LuCy4n3/ESCboard/v2/ESC_HF/componente/ouroboros/Ouroboros_transparent.png

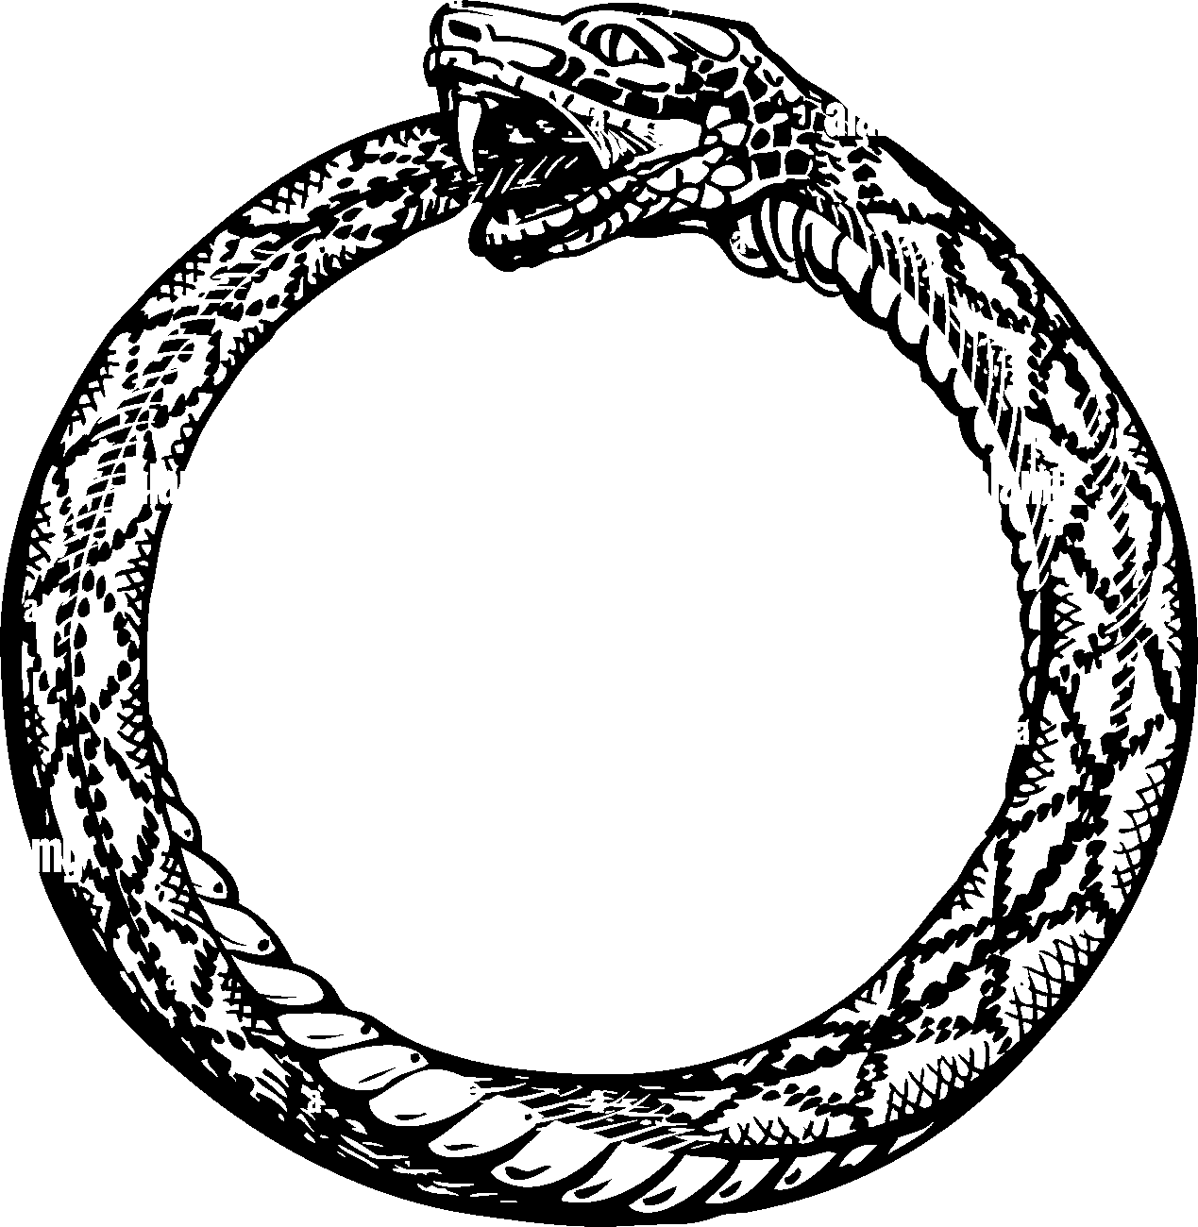
v2/ESC_HF/componente/ouroboros/Ouroboros_transparent.png
