LuCy4n3/ESCboard/v2/ESC_HF/componente/ouroboros/Simbol_KiCad_alb.png

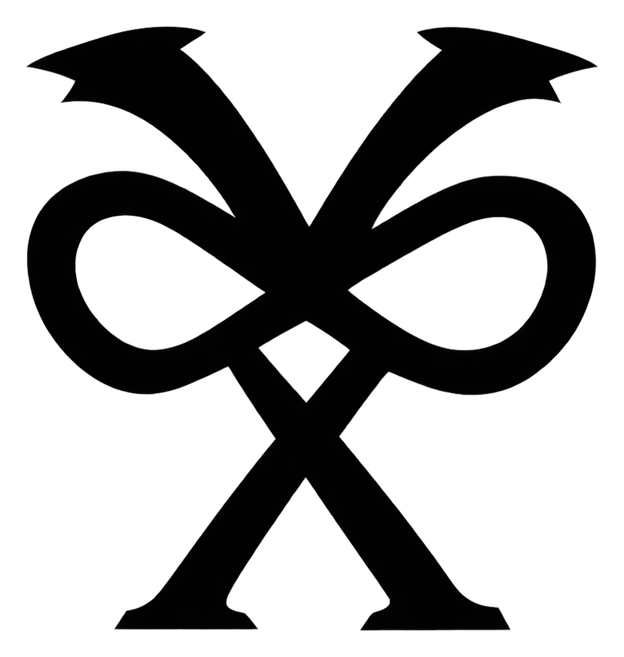
v2/ESC_HF/componente/ouroboros/Simbol_KiCad_alb.png
