LuCy4n3/ESCboard/v2/ESC_HF/componente/74437346220(inductor)/WE-LHMI_7030.step

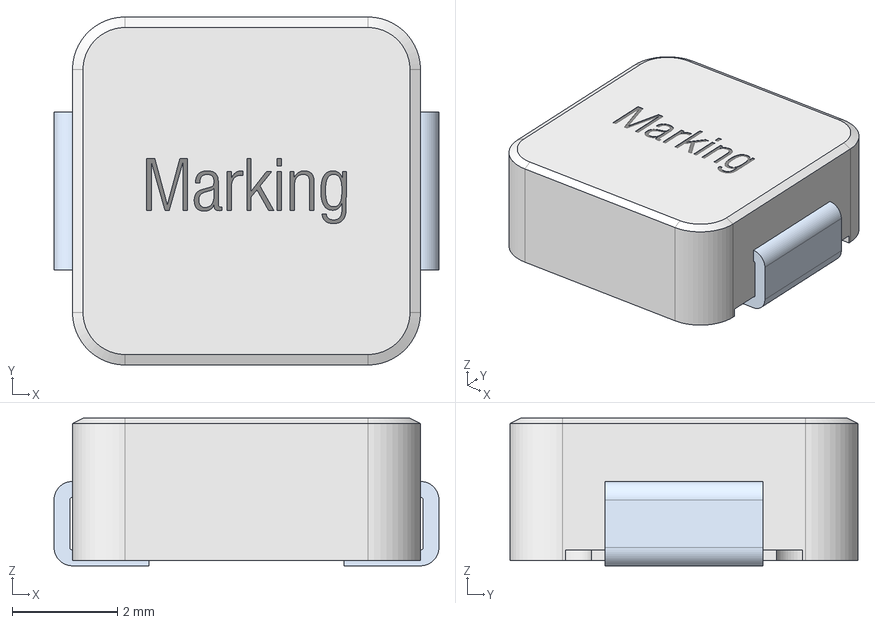
[picture p3: CAD file, 2026-11-10]
v2/ESC_HF/componente/74437346220(inductor)/WE-LHMI_7030.step
7.30 x 6.60 x 2.80 mm
