LuCy4n3/ESCboard/v2/ESC_HF/componente/CST272FK-13-R001AA/CST272FK-13-R001AA.step

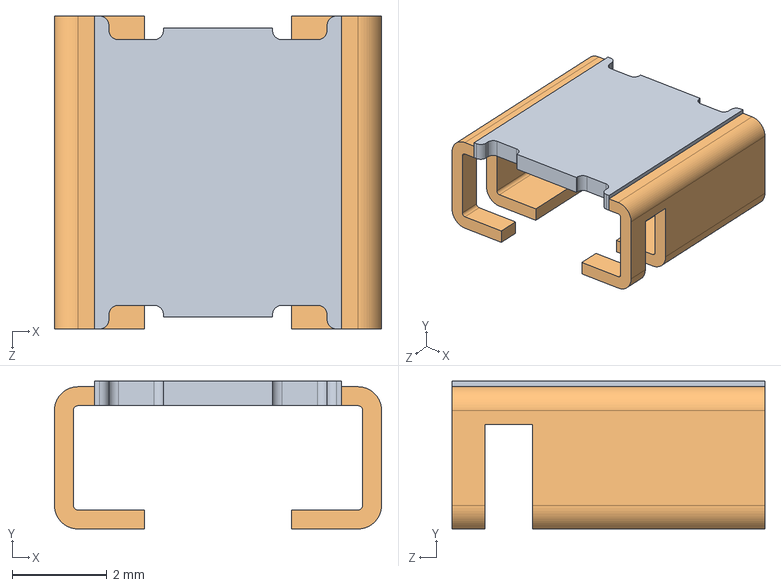
[picture p4: CAD file, 2026-11-10]
v2/ESC_HF/componente/CST272FK-13-R001AA/CST272FK-13-R001AA.step
6.90 x 3.12 x 6.60 mm
