LuCy4n3/ESCboard/v2/ESC_HF/componente/DRV8323RHRGZR/DRV8323RHRGZR.step

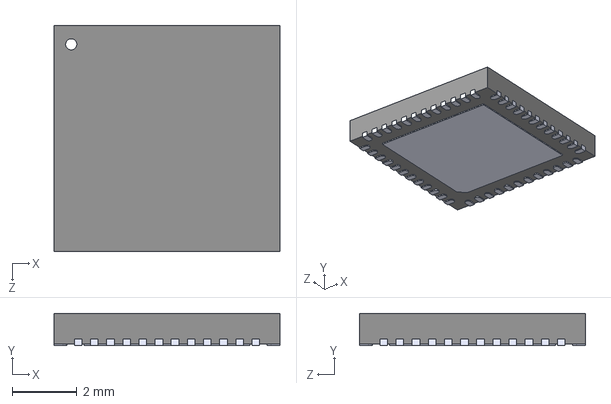
[picture p5: CAD file, 2026-11-10]
v2/ESC_HF/componente/DRV8323RHRGZR/DRV8323RHRGZR.step
7.00 x 1.00 x 7.00 mm
