LuCy4n3/ESCboard/v2/ESC_HF/componente/STM32H750VBT6/STM32H750VBT6TR.step

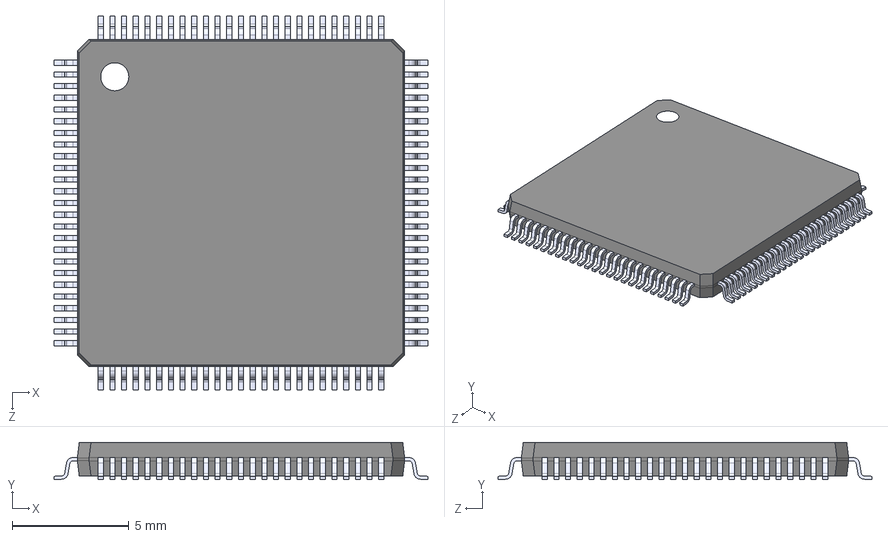
[picture p6: CAD file, 2026-11-10]
v2/ESC_HF/componente/STM32H750VBT6/STM32H750VBT6TR.step
16.0 x 1.60 x 16.0 mm
