LuCy4n3/ESCboard/v1/ESC_HS/esc_design/esc_design.kicad_pcb

## KiCad design v1/ESC_HS/esc_design/esc_design.kicad_pcb (2026-11-10, an earlier design)

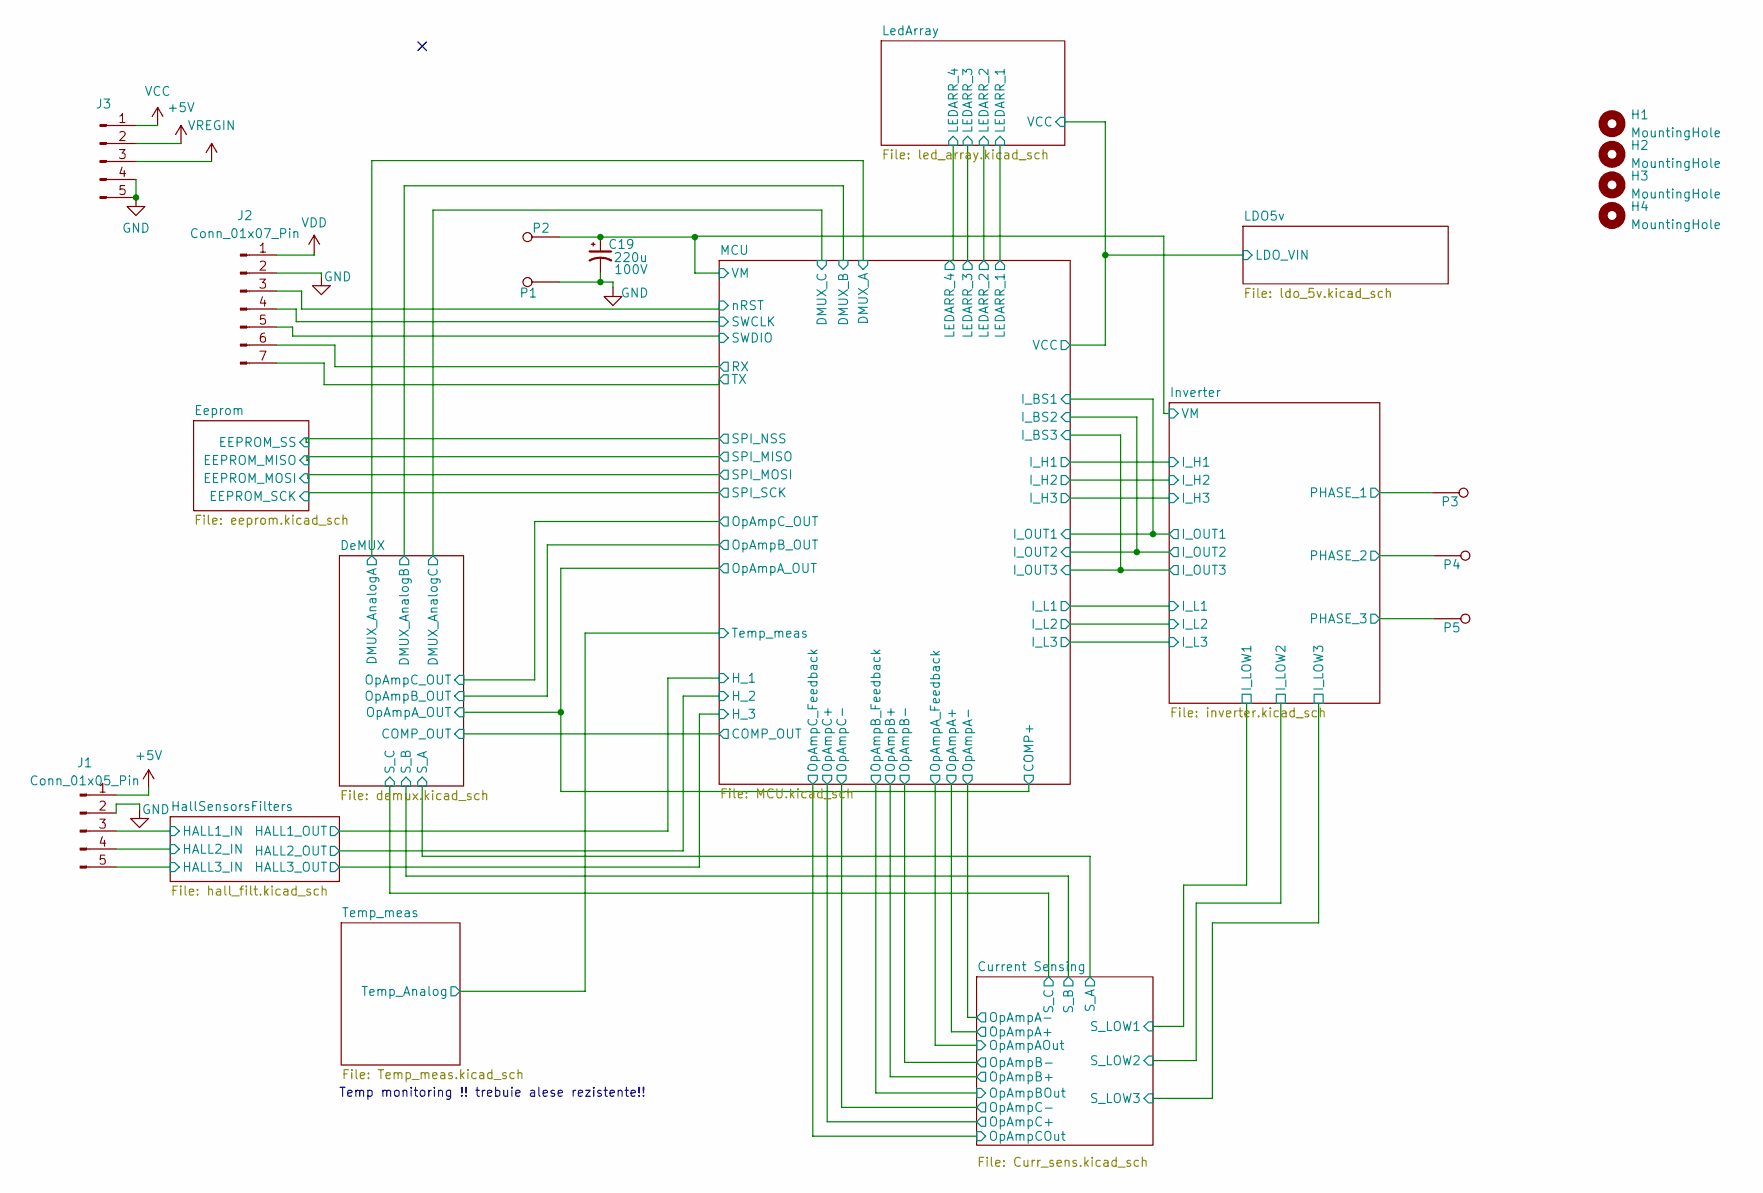
[picture p7: schematic esc_design.kicad_sch]

Parts:
C19: 220u; CP_Radial_D12.5mm_P5.00mm
H1, H2, H3, H4: MountingHole; MountingHole_3.2mm_M3
J1, J3: Conn_01x05_Pin; PinSocket_1x05_P2.54mm_Vertical
J2: Conn_01x07_Pin; PinSocket_1x07_P2.54mm_Vertical
P1, P2, P3, P4, P5: Conn_Power

Connections:
+5V: J1.1, J3.2; also elsewhere on the board
/HallSensorsFilters/HALL1_IN: J1.3; also elsewhere on the board
/HallSensorsFilters/HALL2_IN: J1.4; also elsewhere on the board
/HallSensorsFilters/HALL3_IN: J1.5; also elsewhere on the board
/Inverter/I_OUT1: P3.1; also elsewhere on the board
/Inverter/I_OUT2: P4.1; also elsewhere on the board
/Inverter/I_OUT3: P5.1; also elsewhere on the board
/Inverter/VM: C19.1, P2.1; also elsewhere on the board
/MCU/SWCLK: J2.4; also elsewhere on the board
/MCU/SWDIO: J2.5; also elsewhere on the board
/MCU/USART1_RX: J2.6; also elsewhere on the board
/MCU/USART1_TX: J2.7; also elsewhere on the board
/MCU/nRST: J2.3; also elsewhere on the board
VCC: J3.1; also elsewhere on the board
VDD: J2.1; also elsewhere on the board
VREGIN: J3.3; also elsewhere on the board

Notes on the sheet:
Temp monitoring !! trebuie alese rezistente!!

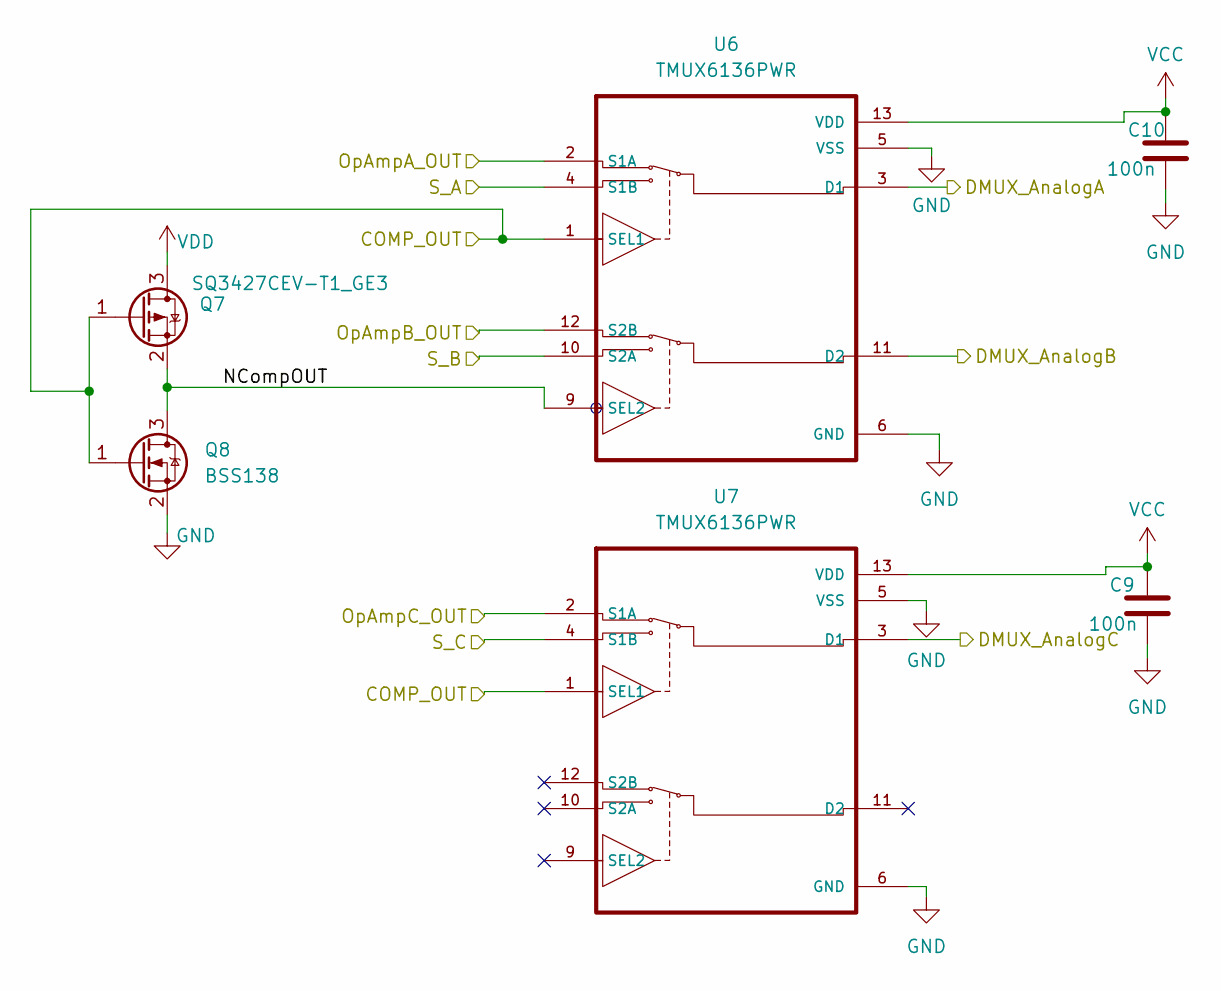
[picture p8: schematic demux.kicad_sch]

Parts:
C9, C10: 100n; C_0603_1608Metric_Pad1.08x0.95mm_HandSolder
Q7: SQ3427CEV-T1_GE3; SOT-23
Q8: BSS138; SOT-23
U6, U7: TMUX6136PWR; SOP65P640X120-16N

Connections:
/Current Sensing/S_A: U6.4 (S1B); also elsewhere on the board
/Current Sensing/S_B: U6.10 (S2A); also elsewhere on the board
/Current Sensing/S_C: U7.4 (S1B); also elsewhere on the board
/DeMUX/DMUX_AnalogA: U6.3 (D1); also elsewhere on the board
/DeMUX/DMUX_AnalogB: U6.11 (D2); also elsewhere on the board
/DeMUX/DMUX_AnalogC: U7.3 (D1); also elsewhere on the board
/DeMUX/NCompOUT: Q7.2 (S), Q8.3 (D), U6.9 (SEL2)
/MCU/COMP3+: U6.2 (S1A); also elsewhere on the board
/MCU/COMP3_OUT: Q7.1 (G), Q8.1 (G), U6.1 (SEL1), U7.1 (SEL1); also elsewhere on the board
/MCU/OpAmp2_OUT: U6.12 (S2B); also elsewhere on the board
/MCU/OpAmp3_OUT: U7.2 (S1A); also elsewhere on the board
VCC: C9.1, C10.1, U6.13 (VDD), U7.13 (VDD); also elsewhere on the board
VDD: Q7.3 (D); also elsewhere on the board

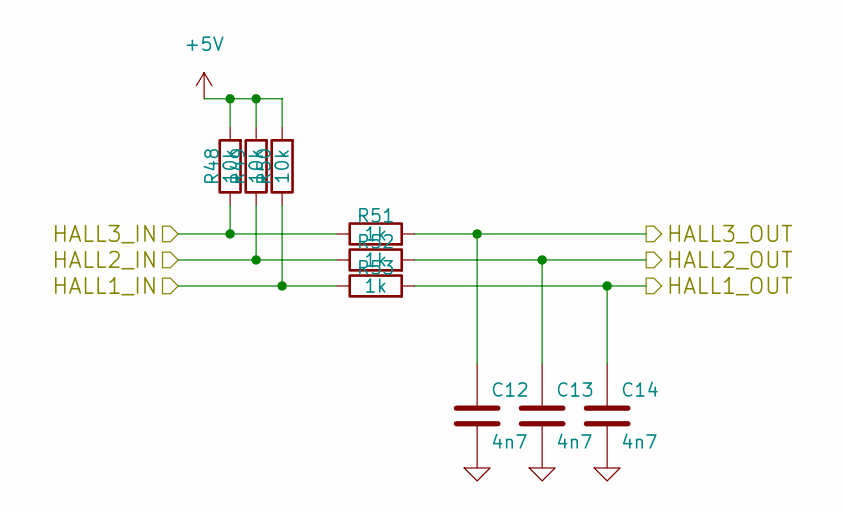
[picture p9: schematic hall_filt.kicad_sch]

Parts:
C12, C13, C14: 4n7; C_0603_1608Metric_Pad1.08x0.95mm_HandSolder
R48, R49, R50: 10k; R_0603_1608Metric_Pad0.98x0.95mm_HandSolder
R51, R52, R53: 1k; R_0603_1608Metric_Pad0.98x0.95mm_HandSolder

Connections:
+5V: R48.2, R49.2, R50.2; also elsewhere on the board
/HallSensorsFilters/HALL1_IN: R50.1, R53.1; also elsewhere on the board
/HallSensorsFilters/HALL1_OUT: C14.1, R53.2; also elsewhere on the board
/HallSensorsFilters/HALL2_IN: R49.1, R52.1; also elsewhere on the board
/HallSensorsFilters/HALL2_OUT: C13.1, R52.2; also elsewhere on the board
/HallSensorsFilters/HALL3_IN: R48.1, R51.1; also elsewhere on the board
/HallSensorsFilters/HALL3_OUT: C12.1, R51.2; also elsewhere on the board

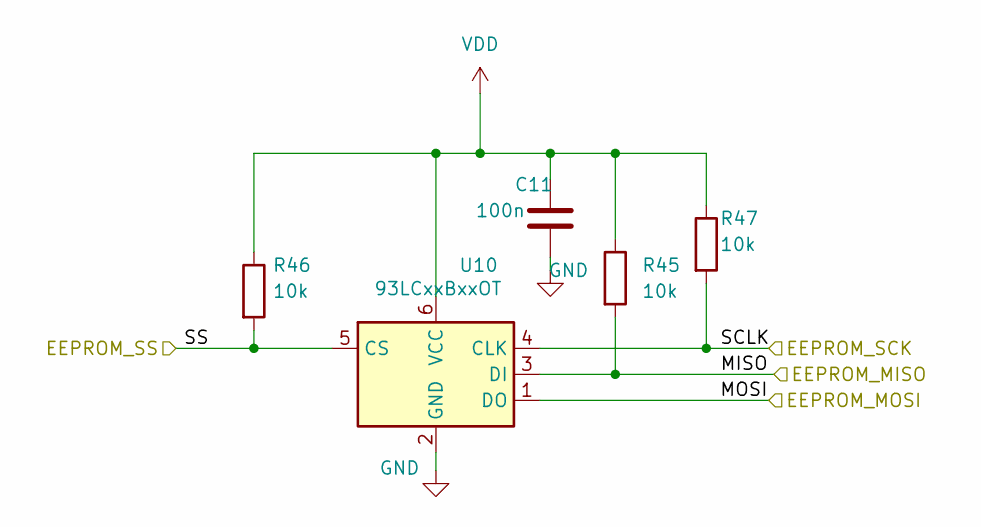
[picture p10: schematic eeprom.kicad_sch]

Parts:
C11: 100n; C_0603_1608Metric_Pad1.08x0.95mm_HandSolder
R45, R46, R47: 10k; R_0603_1608Metric_Pad0.98x0.95mm_HandSolder
U10: 93LCxxBxxOT; SOT-23-6

Connections:
/Eeprom/MISO: R45.2, U10.3 (DI); also elsewhere on the board
/Eeprom/MOSI: U10.1 (DO); also elsewhere on the board
/Eeprom/SCLK: R47.2, U10.4 (CLK); also elsewhere on the board
/Eeprom/SS: R46.2, U10.5 (CS); also elsewhere on the board
VDD: C11.1, R45.1, R46.1, R47.1, U10.6 (VCC); also elsewhere on the board

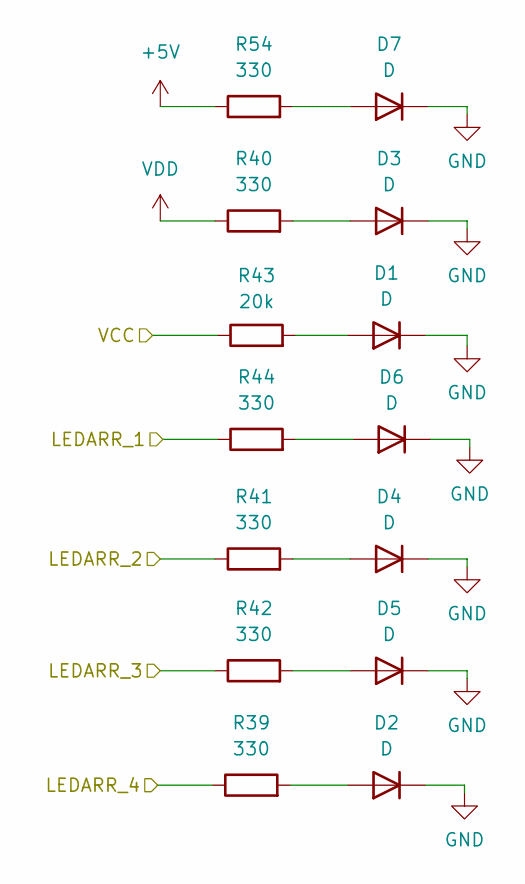
[picture p11: schematic led_array.kicad_sch]

Parts:
D1, D2, D3, D4, D5, D6, D7: D; D_1206_3216Metric_Pad1.42x1.75mm_HandSolder
R39, R40, R41, R42, R44, R54: 330; R_0603_1608Metric_Pad0.98x0.95mm_HandSolder
R43: 20k; R_0603_1608Metric_Pad0.98x0.95mm_HandSolder

Connections:
+5V: R54.1; also elsewhere on the board
/LedArray/LEDARR_1: R44.1; also elsewhere on the board
/LedArray/LEDARR_2: R41.1; also elsewhere on the board
/LedArray/LEDARR_3: R42.1; also elsewhere on the board
/LedArray/LEDARR_4: R39.1; also elsewhere on the board
unnamed: D1.2 (A), R43.2
unnamed: D2.2 (A), R39.2
unnamed: D3.2 (A), R40.2
unnamed: D4.2 (A), R41.2
unnamed: D5.2 (A), R42.2
unnamed: D6.2 (A), R44.2
unnamed: D7.2 (A), R54.2
VCC: R43.1; also elsewhere on the board
VDD: R40.1; also elsewhere on the board

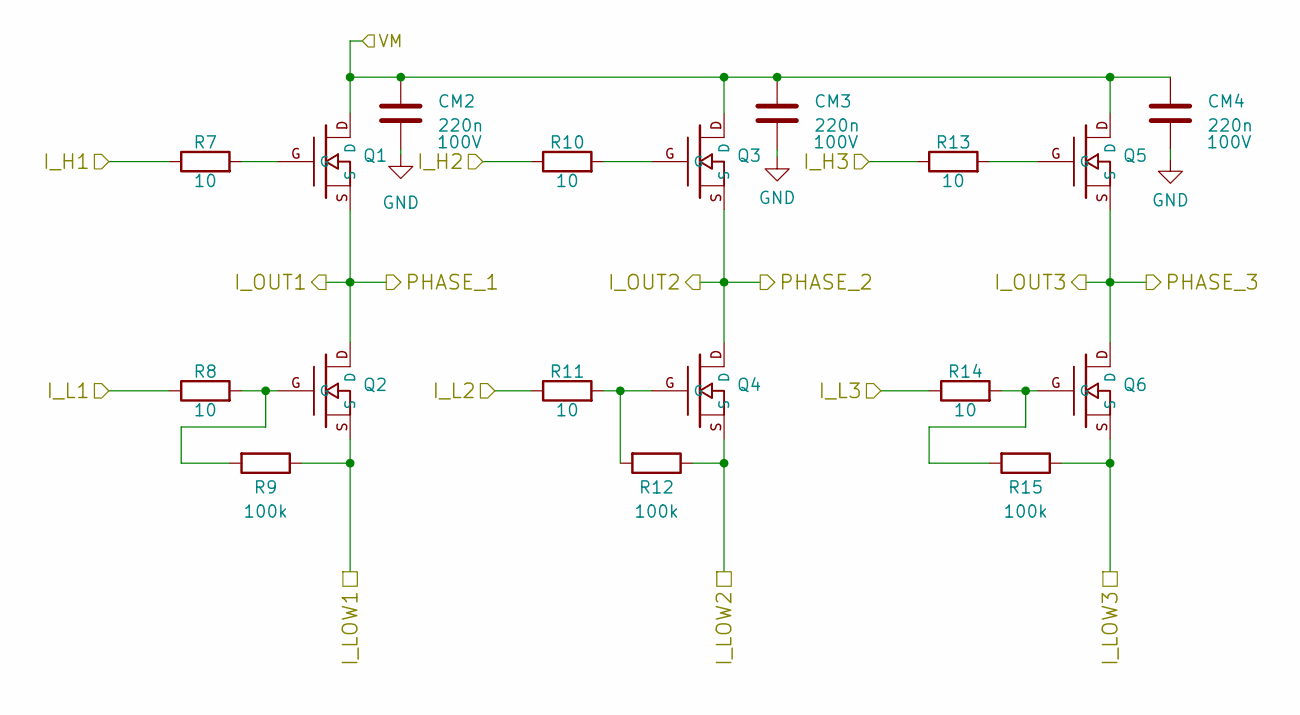
[picture p12: schematic inverter.kicad_sch]

Parts:
CM2, CM3, CM4: 220n; C_0603_1608Metric_Pad1.08x0.95mm_HandSolder
Q1, Q2, Q3, Q4, Q5, Q6: IRFS7530PBF
R7, R8, R10, R11, R13, R14: 10; R_0603_1608Metric_Pad0.98x0.95mm_HandSolder
R9, R12, R15: 100k; R_0603_1608Metric_Pad0.98x0.95mm_HandSolder

Connections:
/Current Sensing/S_LOW1: Q2.S, R9.1; also elsewhere on the board
/Current Sensing/S_LOW2: Q4.S, R12.1; also elsewhere on the board
/Current Sensing/S_LOW3: Q6.S, R15.1; also elsewhere on the board
/Inverter/I_H1: R7.1; also elsewhere on the board
/Inverter/I_H2: R10.1; also elsewhere on the board
/Inverter/I_H3: R13.1; also elsewhere on the board
/Inverter/I_L1: R8.1; also elsewhere on the board
/Inverter/I_L2: R11.1; also elsewhere on the board
/Inverter/I_L3: R14.1; also elsewhere on the board
/Inverter/I_OUT1: Q1.S, Q2.D; also elsewhere on the board
/Inverter/I_OUT2: Q3.S, Q4.D; also elsewhere on the board
/Inverter/I_OUT3: Q5.S, Q6.D; also elsewhere on the board
/Inverter/VM: CM2.1, CM3.1, CM4.1, Q1.D, Q3.D, Q5.D; also elsewhere on the board
unnamed: Q1.G, R7.2
unnamed: Q2.G, R8.2, R9.2
unnamed: Q3.G, R10.2
unnamed: Q4.G, R11.2, R12.2
unnamed: Q5.G, R13.2
unnamed: Q6.G, R14.2, R15.2

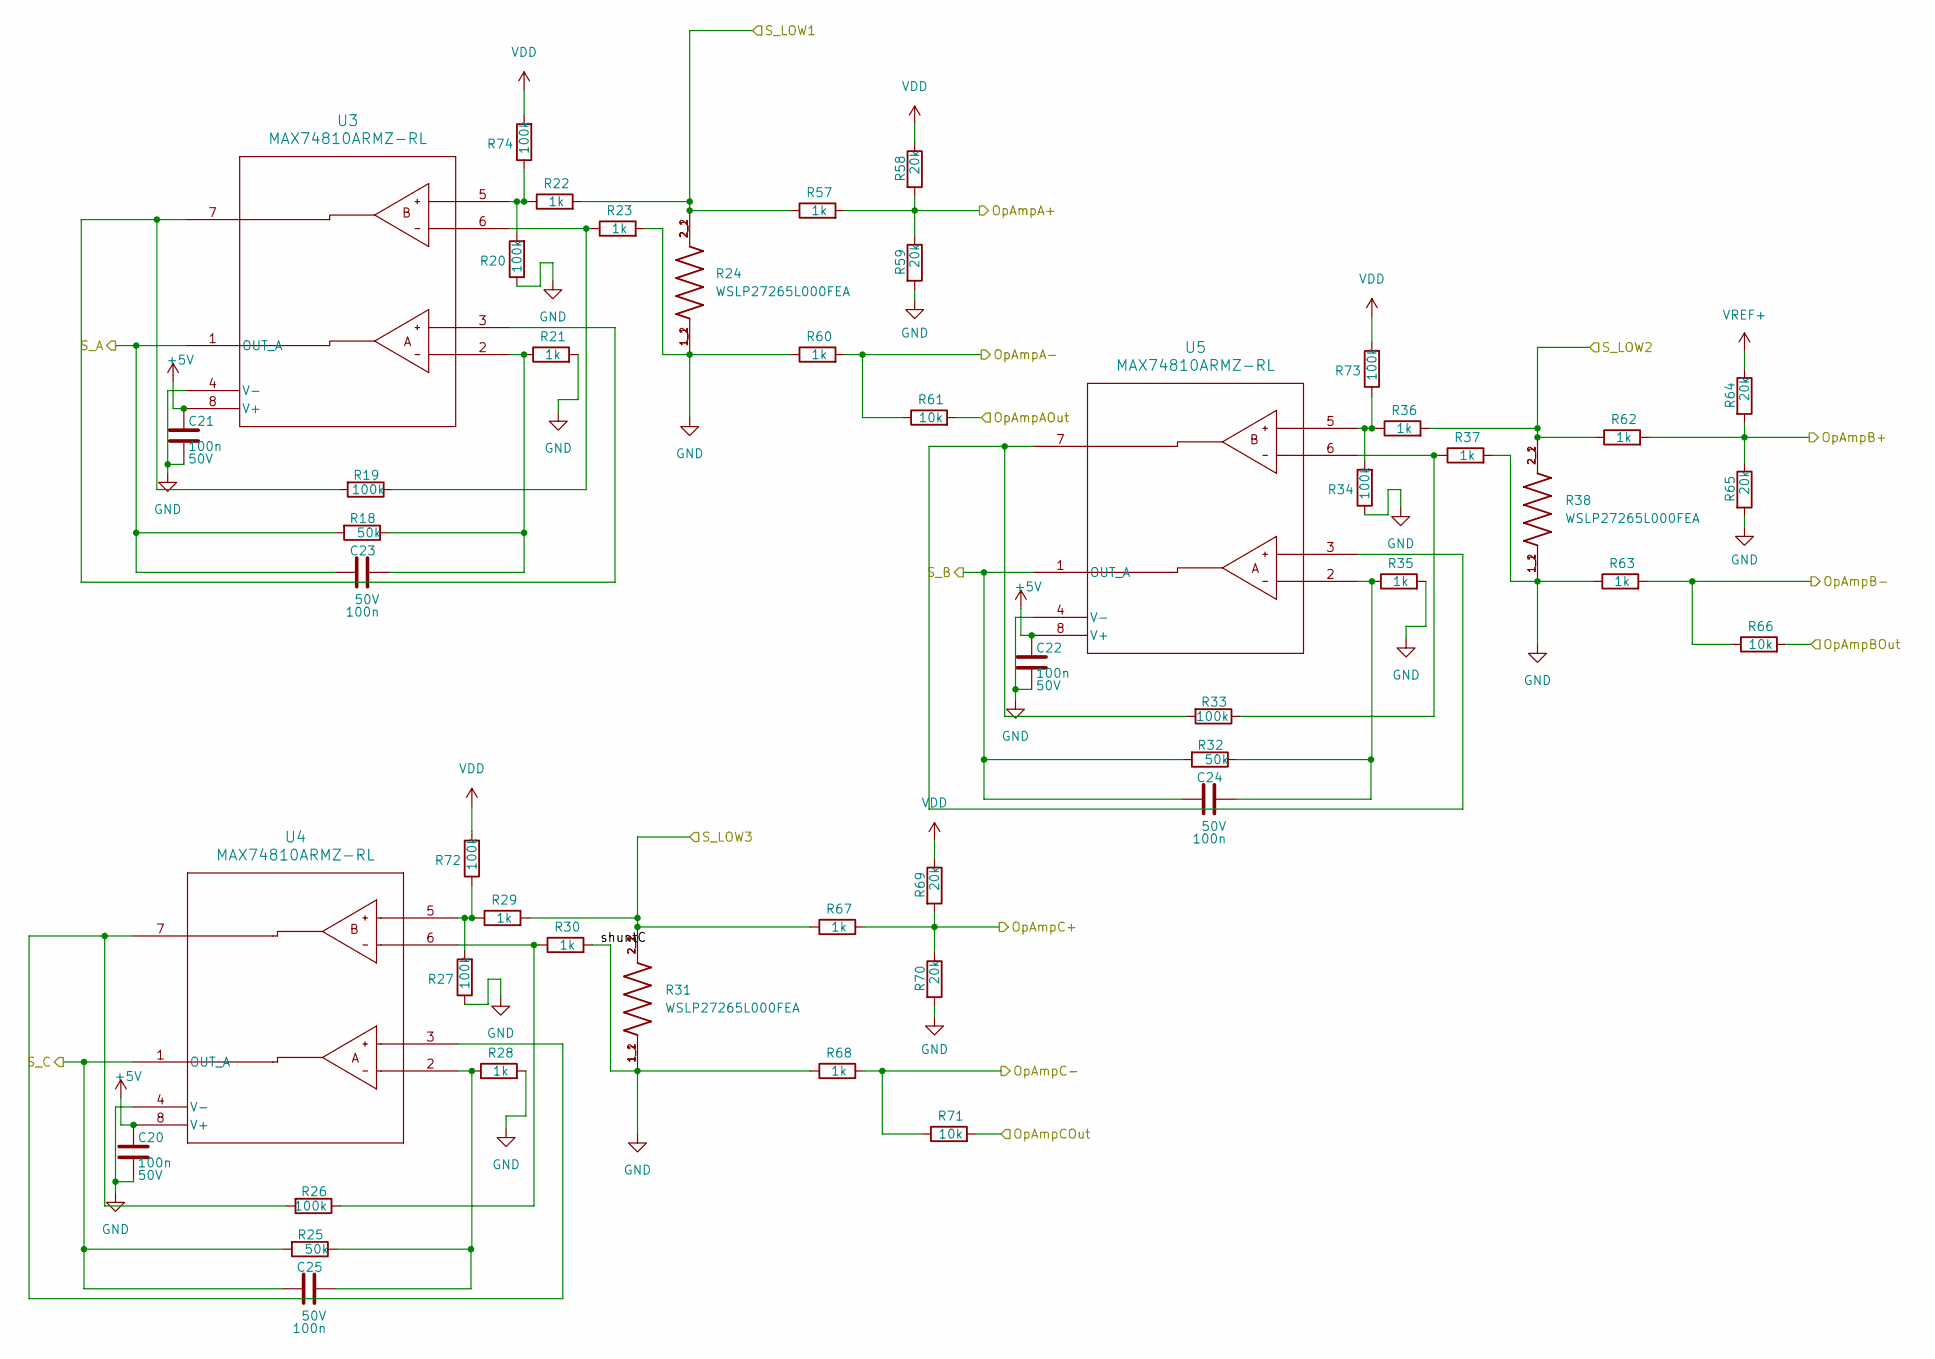
[picture p13: schematic Curr_sens.kicad_sch]

Parts:
C20, C21, C22, C23, C24, C25: 100n; C_0603_1608Metric_Pad1.08x0.95mm_HandSolder
R18, R25, R32: 50k; R_0603_1608Metric_Pad0.98x0.95mm_HandSolder
R19, R20, R26, R27, R33, R34, R72, R73, R74: 100k; R_0603_1608Metric_Pad0.98x0.95mm_HandSolder
R21, R22, R23, R28, R29, R30, R35, R36, R37, R57, R60, R62, R63, R67, R68: 1k; R_0603_1608Metric_Pad0.98x0.95mm_HandSolder
R24, R31, R38: WSLP27265L000FEA; RES_WSLP2726L2000FEA
R58, R59, R64, R65, R69, R70: 20k; R_0603_1608Metric_Pad0.98x0.95mm_HandSolder
R61, R66, R71: 10k; R_0603_1608Metric_Pad0.98x0.95mm_HandSolder
U3, U4, U5: MAX74810ARMZ-RL; MAX74810ARMZ_ADI

Connections:
+5V: C20.1, C21.1, C22.1, U3.8 (V+), U4.8 (V+), U5.8 (V+); also elsewhere on the board
/Current Sensing/S_A: C23.1, R18.2, U3.1 (OUT_A); also elsewhere on the board
/Current Sensing/S_B: C24.1, R32.2, U5.1 (OUT_A); also elsewhere on the board
/Current Sensing/S_C: C25.1, R25.2, U4.1 (OUT_A); also elsewhere on the board
/Current Sensing/S_LOW1: R22.2, R24.2_1, R24.2_2, R57.1; also elsewhere on the board
/Current Sensing/S_LOW2: R36.2, R38.2_1, R38.2_2, R62.1; also elsewhere on the board
/Current Sensing/S_LOW3: R29.2, R31.2_1, R31.2_2, R67.1; also elsewhere on the board
/MCU/COMP3+: R61.2; also elsewhere on the board
/MCU/OpAmp1+: R57.2, R58.2, R59.1; also elsewhere on the board
/MCU/OpAmp1-: R60.2, R61.1; also elsewhere on the board
/MCU/OpAmp2+: R62.2, R64.2, R65.1; also elsewhere on the board
/MCU/OpAmp2-: R63.2, R66.1; also elsewhere on the board
/MCU/OpAmp2_OUT: R66.2; also elsewhere on the board
/MCU/OpAmp3+: R67.2, R69.2, R70.1; also elsewhere on the board
/MCU/OpAmp3-: R68.2, R71.1; also elsewhere on the board
/MCU/OpAmp3_OUT: R71.2; also elsewhere on the board
unnamed: C23.2, R18.1, R21.1, U3.2
unnamed: C24.2, R32.1, R35.1, U5.2
unnamed: C25.2, R25.1, R28.1, U4.2
unnamed: R19.1, R23.1, U3.6
unnamed: R19.2, U3.3, U3.7
unnamed: R20.2, R22.1, R74.1, U3.5
unnamed: R26.1, R30.1, U4.6
unnamed: R26.2, U4.3, U4.7
unnamed: R27.2, R29.1, R72.1, U4.5
unnamed: R33.1, R37.1, U5.6
unnamed: R33.2, U5.3, U5.7
VDD: R58.1, R69.1, R72.2, R73.2, R74.2; also elsewhere on the board
VREF+: R64.1; also elsewhere on the board

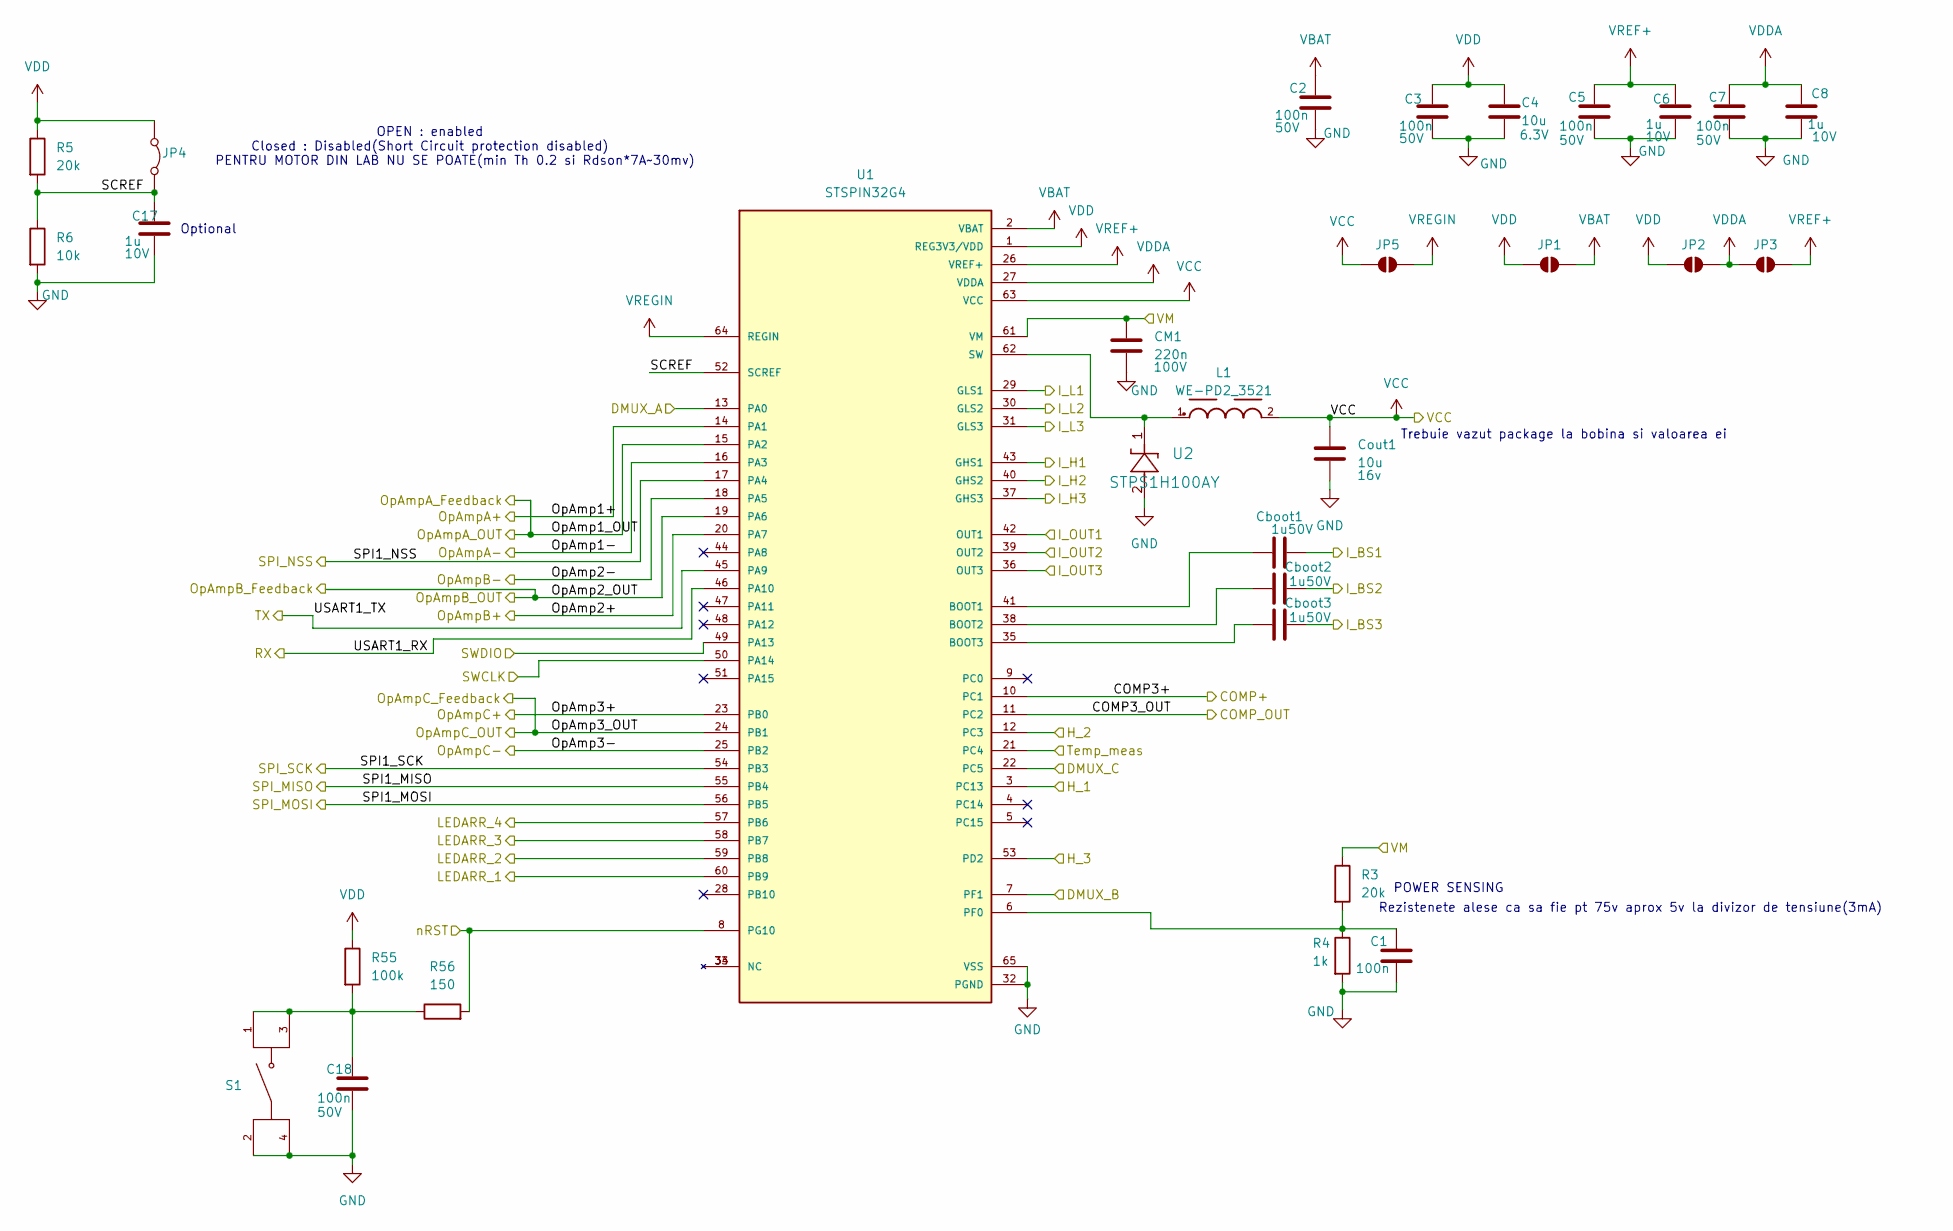
[picture p14: schematic MCU.kicad_sch]

Parts:
C1, C2, C3, C5, C7, C18: 100n; C_0603_1608Metric_Pad1.08x0.95mm_HandSolder
C4: 10u; C_0603_1608Metric_Pad1.08x0.95mm_HandSolder
C6, C8, C17: 1u; C_0603_1608Metric_Pad1.08x0.95mm_HandSolder
CM1: 220n; C_0603_1608Metric_Pad1.08x0.95mm_HandSolder
Cboot1, Cboot2, Cboot3: 1u; C_1206_3216Metric_Pad1.33x1.80mm_HandSolder
Cout1: 10u; C_1206_3216Metric
JP1, JP2, JP3, JP5: SolderJumper_2_Open; SolderJumper-2_P1.3mm_Open_RoundedPad1.0x1.5mm
JP4: Jumper_2_Bridged; TestPoint_2Pads_Pitch2.54mm_Drill0.8mm
L1: WE-PD2_3521
R3, R5: 20k; R_0603_1608Metric_Pad0.98x0.95mm_HandSolder
R4: 1k; R_0603_1608Metric_Pad0.98x0.95mm_HandSolder
R6: 10k; R_0603_1608Metric_Pad0.98x0.95mm_HandSolder
R55: 100k; R_0603_1608Metric_Pad0.98x0.95mm_HandSolder
R56: 150; R_0603_1608Metric_Pad0.98x0.95mm_HandSolder
S1: TS04-66-43-BK-100-SMT-TR; SW_TS04-66-43-BK-100-SMT-TR
U1: STSPIN32G4; QFN50P900X900X100-65N
U2: STPS1H100AY; SMA_STM

Connections:
/DeMUX/DMUX_AnalogA: U1.13 (PA0); also elsewhere on the board
/DeMUX/DMUX_AnalogB: U1.7 (PF1); also elsewhere on the board
/DeMUX/DMUX_AnalogC: U1.22 (PC5); also elsewhere on the board
/Eeprom/MISO: U1.55 (PB4); also elsewhere on the board
/Eeprom/MOSI: U1.56 (PB5); also elsewhere on the board
/Eeprom/SCLK: U1.54 (PB3); also elsewhere on the board
/Eeprom/SS: U1.17 (PA4); also elsewhere on the board
/HallSensorsFilters/HALL1_OUT: U1.3 (PC13); also elsewhere on the board
/HallSensorsFilters/HALL2_OUT: U1.12 (PC3); also elsewhere on the board
/HallSensorsFilters/HALL3_OUT: U1.53 (PD2); also elsewhere on the board
/Inverter/I_H1: U1.43 (GHS1); also elsewhere on the board
/Inverter/I_H2: U1.40 (GHS2); also elsewhere on the board
/Inverter/I_H3: U1.37 (GHS3); also elsewhere on the board
/Inverter/I_L1: U1.29 (GLS1); also elsewhere on the board
/Inverter/I_L2: U1.30 (GLS2); also elsewhere on the board
/Inverter/I_L3: U1.31 (GLS3); also elsewhere on the board
/Inverter/I_OUT1: Cboot1.2, U1.42 (OUT1); also elsewhere on the board
/Inverter/I_OUT2: Cboot2.2, U1.39 (OUT2); also elsewhere on the board
/Inverter/I_OUT3: Cboot3.2, U1.36 (OUT3); also elsewhere on the board
/Inverter/VM: CM1.1, R3.1, U1.61 (VM); also elsewhere on the board
/LedArray/LEDARR_1: U1.60 (PB9); also elsewhere on the board
/LedArray/LEDARR_2: U1.59 (PB8); also elsewhere on the board
/LedArray/LEDARR_3: U1.58 (PB7); also elsewhere on the board
/LedArray/LEDARR_4: U1.57 (PB6); also elsewhere on the board
/MCU/COMP3+: U1.10 (PC1), U1.15 (PA2); also elsewhere on the board
/MCU/COMP3_OUT: U1.11 (PC2); also elsewhere on the board
/MCU/OpAmp1+: U1.14 (PA1); also elsewhere on the board
/MCU/OpAmp1-: U1.16 (PA3); also elsewhere on the board
/MCU/OpAmp2+: U1.20 (PA7); also elsewhere on the board
/MCU/OpAmp2-: U1.18 (PA5); also elsewhere on the board
/MCU/OpAmp2_OUT: U1.19 (PA6); also elsewhere on the board
/MCU/OpAmp3+: U1.23 (PB0); also elsewhere on the board
/MCU/OpAmp3-: U1.25 (PB2); also elsewhere on the board
/MCU/OpAmp3_OUT: U1.24 (PB1); also elsewhere on the board
/MCU/SCREF: C17.1, JP4.2 (B), R5.2, R6.1, U1.52 (SCREF)
/MCU/SWCLK: U1.50 (PA14); also elsewhere on the board
/MCU/SWDIO: U1.49 (PA13); also elsewhere on the board
/MCU/Temp_meas: U1.21 (PC4); also elsewhere on the board
/MCU/USART1_RX: U1.46 (PA10); also elsewhere on the board
/MCU/USART1_TX: U1.45 (PA9); also elsewhere on the board
/MCU/nRST: R56.2, U1.8 (PG10); also elsewhere on the board
unnamed: C18.1, R55.2, R56.1, S1.1, S1.3
unnamed: Cboot1.1, U1.41 (BOOT1)
unnamed: Cboot2.1, U1.38 (BOOT2)
unnamed: Cboot3.1, U1.35 (BOOT3)
unnamed: C1.1, R3.2, R4.1, U1.6 (PF0)
unnamed: L1.1, U1.62 (SW), U2.1
VBAT: C2.1, JP1.2 (B), U1.2 (VBAT)
VCC: Cout1.1, JP5.1 (A), L1.2, U1.63 (VCC); also elsewhere on the board
VDD: C3.1, C4.1, JP1.1 (A), JP2.1 (A), JP4.1 (A), R5.1, R55.1, U1.1 (REG3V3/VDD); also elsewhere on the board
VDDA: C7.1, C8.1, JP2.2 (B), JP3.1 (A), U1.27 (VDDA)
VREF+: C5.1, C6.1, JP3.2 (B), U1.26 (VREF+); also elsewhere on the board
VREGIN: JP5.2 (B), U1.64 (REGIN); also elsewhere on the board

Notes on the sheet:
OPEN : enabled Closed : Disabled(Short Circuit protection disabled)
Optional
Rezistenete alese ca sa fie pt 75v aprox 5v la divizor de tensiune(3mA)
Trebuie vazut package la bobina si valoarea ei
PENTRU MOTOR DIN LAB NU SE POATE(min Th 0.2 si Rdson*7A~30mv)
POWER SENSING

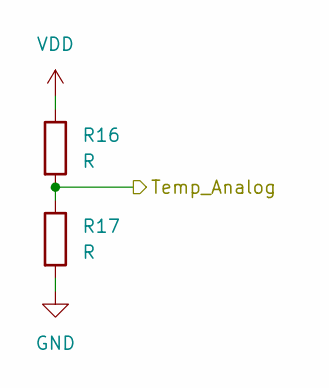
[picture p15: schematic Temp_meas.kicad_sch]

Parts:
R16: R; R_0603_1608Metric_Pad0.98x0.95mm_HandSolder
R17: R; R_LDR_4.9x4.2mm_P2.54mm_Vertical

Connections:
/MCU/Temp_meas: R16.2, R17.1; also elsewhere on the board
VDD: R16.1; also elsewhere on the board

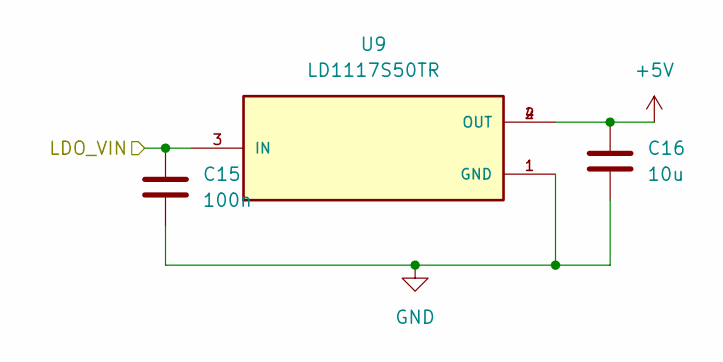
[picture p16: schematic ldo_5v.kicad_sch]

Parts:
C15: 100n; C_0603_1608Metric_Pad1.08x0.95mm_HandSolder
C16: 10u; C_0603_1608Metric_Pad1.08x0.95mm_HandSolder
U9: LD1117S50TR; SOT230P700X180-4N

Connections:
+5V: C16.1, U9.2 (OUT), U9.4 (OUT); also elsewhere on the board
VCC: C15.1, U9.3 (IN); also elsewhere on the board

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
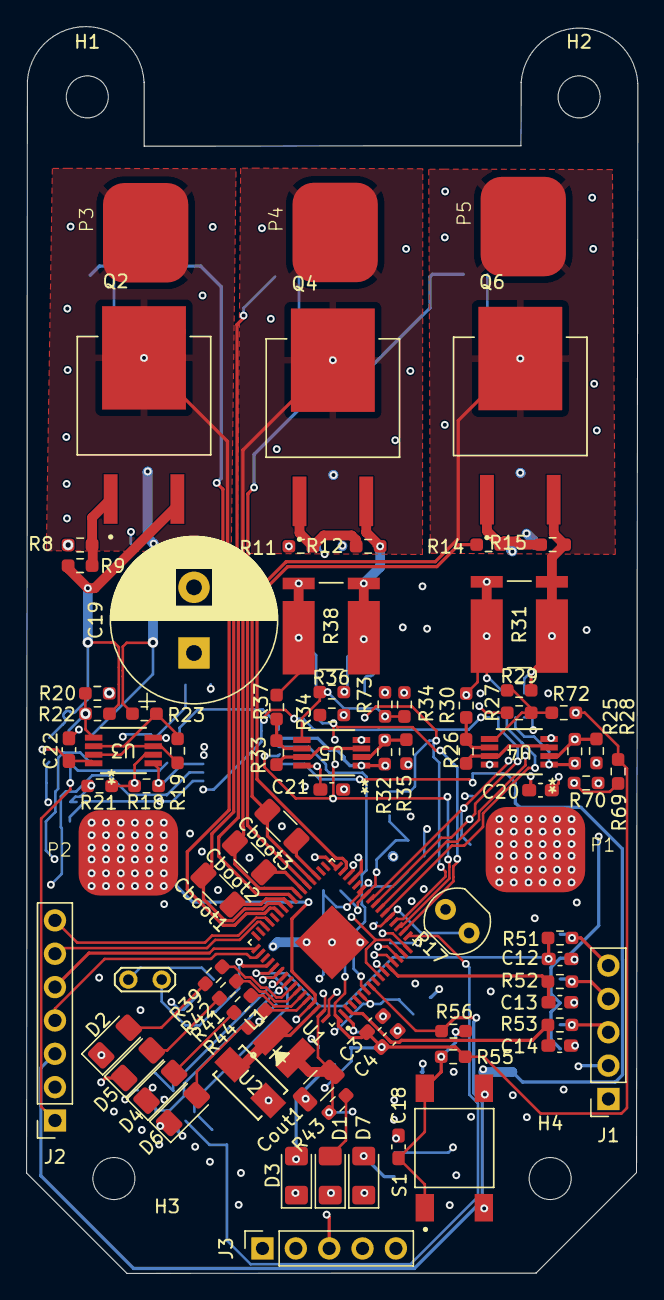
[picture p17: board esc_design.kicad_pcb from above]

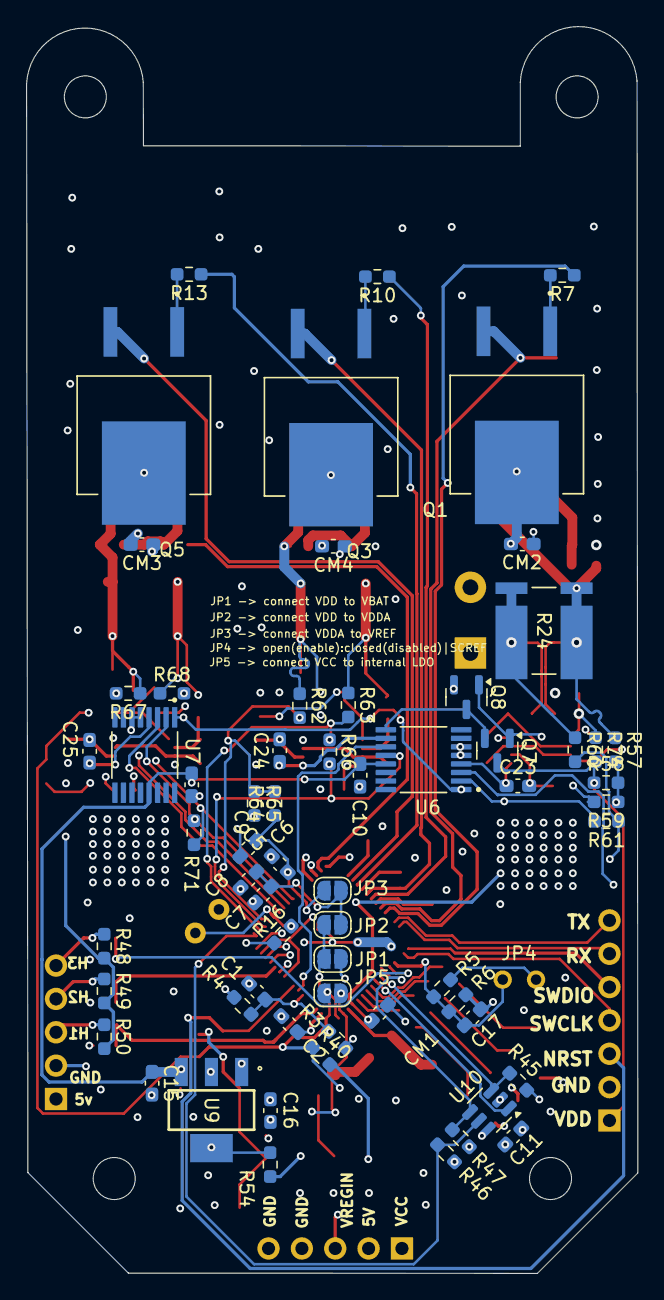
[picture p18: board esc_design.kicad_pcb from below]

Board: 4 copper layers, 46.5 x 95.0 mm, 149 parts (63 on the bottom side), 90 nets.

Other parts of the board:
R34#2: 100k; R_0603_1608Metric_Pad0.98x0.95mm_HandSolder
