LuCy4n3/ESCboard/v2/ESC_HF/ESC_HF/ESC_HF.kicad_pcb

## KiCad design v2/ESC_HF/ESC_HF/ESC_HF.kicad_pcb (2026-11-10)

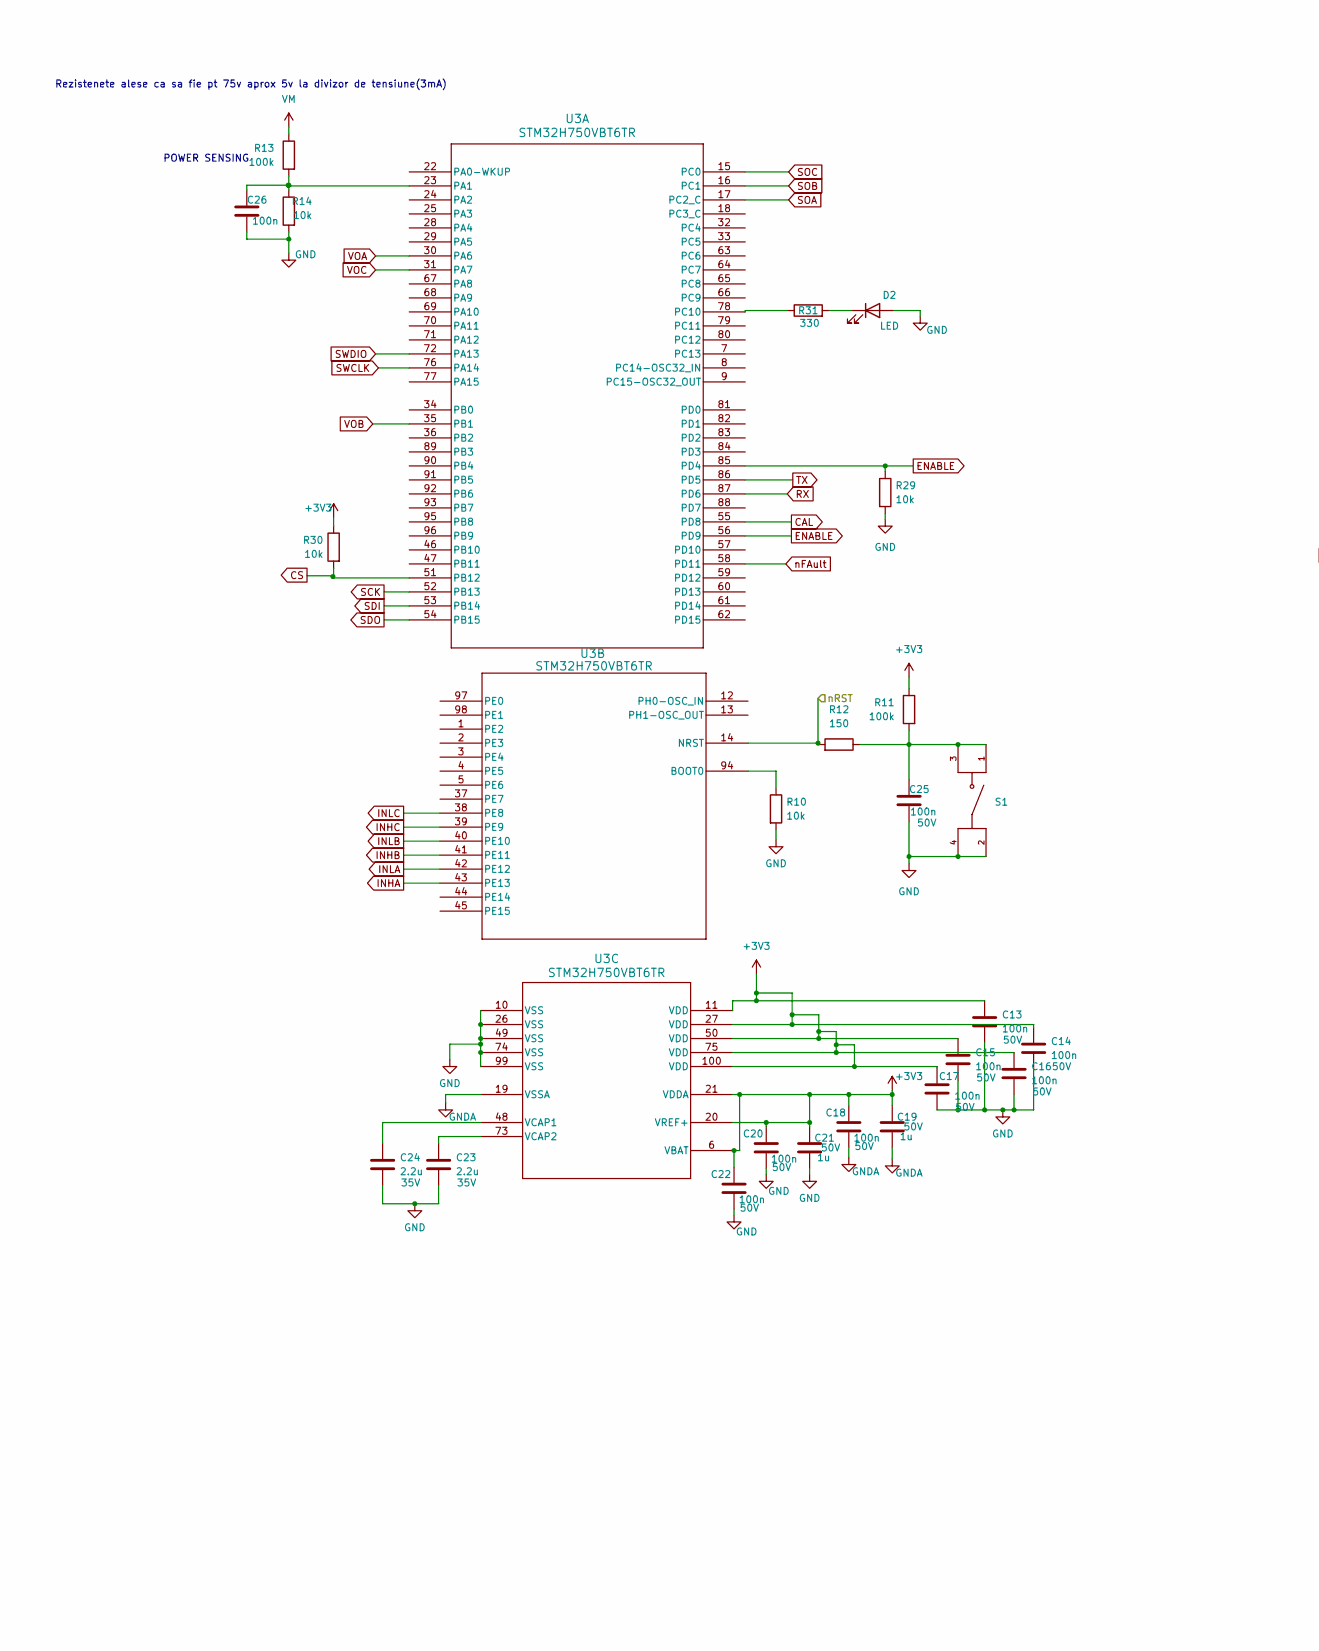
[picture p19: schematic ESC_HF.kicad_sch, part in row 1, column 1]

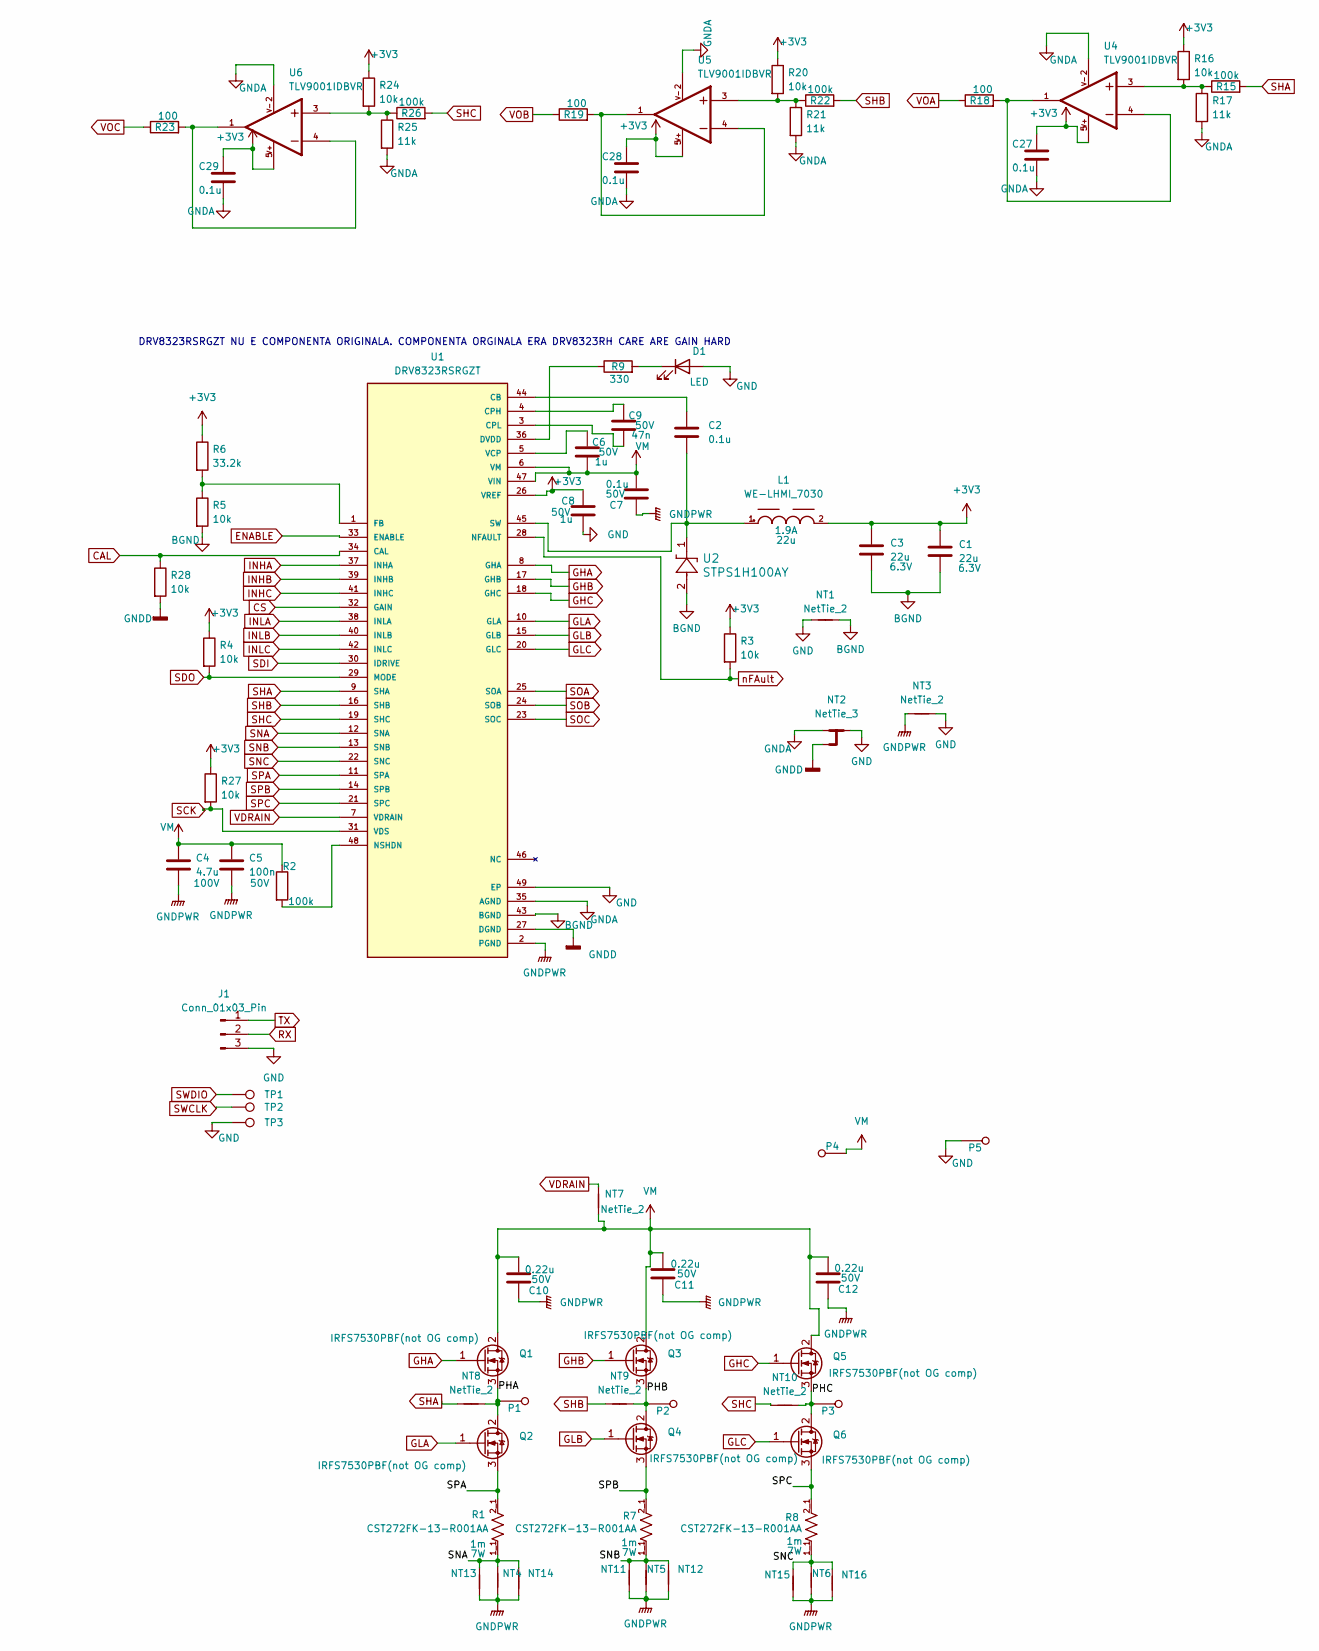
[picture p20: schematic ESC_HF.kicad_sch, part in row 1, column 2]

Parts:
C1, C3: 22u; C_0603_1608Metric_Pad1.08x0.95mm_HandSolder
C2, C7, C27, C28, C29: 0.1u; C_0603_1608Metric_Pad1.08x0.95mm_HandSolder
C4: 4.7u; C_0603_1608Metric_Pad1.08x0.95mm_HandSolder
C5, C13, C14, C15, C16, C17, C18, C20, C22, C25, C26: 100n; C_0603_1608Metric_Pad1.08x0.95mm_HandSolder
C6, C8, C19, C21: 1u; C_0603_1608Metric_Pad1.08x0.95mm_HandSolder
C9: 47n; C_0603_1608Metric_Pad1.08x0.95mm_HandSolder
C10, C11, C12: 0.22u; C_0603_1608Metric_Pad1.08x0.95mm_HandSolder
C23, C24: 2.2u; C_0603_1608Metric_Pad1.08x0.95mm_HandSolder
D1, D2: LED; LED_1206_3216Metric_Pad1.42x1.75mm_HandSolder
J1: Conn_01x03_Pin; PinHeader_1x03_P2.54mm_Vertical
L1: WE-LHMI_7030
NT1, NT7: NetTie_2; NetTie-2_SMD_Pad0.5mm
NT2: NetTie_3; NetTie-3_SMD_Pad0.5mm
NT3, NT4, NT5, NT6, NT8, NT9, NT10, NT11, NT12, NT13, NT14, NT15, NT16: NetTie_2; NetTie-2_SMD_Pad2.0mm
P1, P2, P3, P4, P5: Conn_Power
Q1, Q2, Q3, Q4, Q5, Q6: IRFS7530PBF(not OG comp); TO-263-2
R1, R7, R8: CST272FK-13-R001AA; PARTREV 18-February-2025
R2, R11, R13, R15, R22, R26: 100k; R_0603_1608Metric_Pad0.98x0.95mm_HandSolder
R3, R4, R5, R10, R14, R16, R20, R24, R27, R28, R29, R30: 10k; R_0603_1608Metric_Pad0.98x0.95mm_HandSolder
R6: 33.2k; R_0603_1608Metric_Pad0.98x0.95mm_HandSolder
R9, R31: 330; R_0603_1608Metric_Pad0.98x0.95mm_HandSolder
R12: 150; R_0603_1608Metric_Pad0.98x0.95mm_HandSolder
R17, R21, R25: 11k; R_0603_1608Metric_Pad0.98x0.95mm_HandSolder
R18, R19, R23: 100; R_0603_1608Metric_Pad0.98x0.95mm_HandSolder
S1: TS04-66-43-BK-100-SMT-TR; SW_TS04-66-43-BK-100-SMT-TR
TP1, TP2, TP3: TestPoint; TestPoint_Pad_D2.0mm
U1: DRV8323RSRGZT; DRV8323RHRGZR; PARTREV AUGUST 2018
U2: STPS1H100AY; SMA_STM
U3: STM32H750VBT6TR; STM32H750VBT6
U4, U5, U6: TLV9001IDBVR; SOT95P280X145-5N; PARTREV R

Connections:
+3V3: C1.1, C3.1, C8.1, C13.1, C14.1, C15.1, C16.1, C17.1, C18.1, C19.1, C20.1, C21.1, C22.1, C27.1, C28.1, C29.1, L1.2, R3.1, R4.1, R6.1, R11.1, R16.1, R20.1, R24.1, R27.1, R30.1, U1.26 (VREF), U3.6 (VBAT), U3.11 (VDD), U3.20 (VREF+), U3.21 (VDDA), U3.27 (VDD), U3.50 (VDD), U3.75 (VDD), U3.100 (VDD), U4.5, U5.5, U6.5
/PHA: NT8.2, P1.1, Q1.3 (S), Q2.2 (D)
/PHB: NT9.2, P2.1, Q3.3 (S), Q4.2 (D)
/PHC: NT10.2, P3.1, Q5.3 (S), Q6.2 (D)
/nRST: R12.2, U3.14 (NRST)
BGND: C1.2, C3.2, NT1.2, R5.2, U1.43 (BGND), U2.2
CAL: R28.1, U1.34 (CAL), U3.55 (PD8)
CS: R30.2, U1.32 (GAIN), U3.51 (PB12)
ENABLE: R29.1, U1.33 (ENABLE), U3.56 (PD9), U3.85 (PD4)
GHA: Q1.1 (G), U1.8 (GHA)
GHB: Q3.1 (G), U1.17 (GHB)
GHC: Q5.1 (G), U1.18 (GHC)
GLA: Q2.1 (G), U1.10 (GLA)
GLB: Q4.1 (G), U1.15 (GLB)
GLC: Q6.1 (G), U1.20 (GLC)
GND: C8.2, C13.2, C14.2, C15.2, C16.2, C17.2, C20.2, C21.2, C22.2, C23.2, C24.2, C25.2, C26.2, D1.2 (A), D2.2 (A), J1.3, NT1.1, NT2.2, NT3.2, P5.1, R10.2, R14.2, R29.2, S1.2, S1.4, TP3.1, U1.49 (EP), U1.V49_1 (EP), U1.V49_2 (EP), U1.V49_3 (EP), U1.V49_4 (EP), U1.V49_5 (EP), U1.V49_6 (EP), U1.V49_7 (EP), U1.V49_8 (EP), U1.V49_9 (EP), U1.V49_10 (EP), U1.V49_11 (EP), U1.V49_12 (EP), U1.V49_13 (EP), U1.V49_14 (EP), U1.V49_15 (EP), U1.V49_16 (EP), U1.V49_17 (EP), U1.V49_18 (EP), U1.V49_19 (EP), U1.V49_20 (EP), U1.V49_21 (EP), U3.10 (VSS), U3.26 (VSS), U3.49 (VSS), U3.74 (VSS), U3.99 (VSS)
GNDA: C18.2, C19.2, C27.2, C28.2, C29.2, NT2.1, R17.2, R21.2, R25.2, U1.35 (AGND), U3.19 (VSSA), U4.2, U5.2, U6.2
GNDD: NT2.3, R28.2, U1.27 (DGND)
GNDPWR: C4.2, C5.2, C7.1, C10.1, C11.1, C12.1, NT3.1, NT4.1, NT5.1, NT6.1, NT11.2, NT12.2, NT13.2, NT14.2, NT15.2, NT16.2, U1.2 (PGND)
INHA: U1.37 (INHA), U3.43 (PE13)
INHB: U1.39 (INHB), U3.41 (PE11)
INHC: U1.41 (INHC), U3.39 (PE9)
INLA: U1.38 (INLA), U3.42 (PE12)
INLB: U1.40 (INLB), U3.40 (PE10)
INLC: U1.42 (INLC), U3.38 (PE8)
unnamed: C25.1, R11.2, R12.1, S1.1, S1.3
unnamed: D1.1 (K), R9.2
unnamed: D2.1 (K), R31.2
unnamed: R15.1, R16.2, R17.1, U4.3
unnamed: R18.2, U4.1, U4.4
unnamed: R19.2, U5.1, U5.4
unnamed: R20.2, R21.1, R22.1, U5.3
unnamed: R23.2, U6.1, U6.4
unnamed: R24.2, R25.1, R26.1, U6.3
unnamed: C2.1, U1.44 (CB)
unnamed: C9.1, U1.4 (CPH)
unnamed: C9.2, U1.3 (CPL)
unnamed: R9.1, U1.36 (DVDD)
unnamed: R5.1, R6.2, U1.1 (FB)
unnamed: R2.2, U1.48 (NSHDN)
unnamed: C2.2, L1.1, U1.45 (SW), U2.1
unnamed: C6.1, U1.5 (VCP)
unnamed: C26.1, R13.2, R14.1, U3.23 (PA1)
unnamed: R31.1, U3.78 (PC10)
unnamed: R10.1, U3.94 (BOOT0)
unnamed: C24.1, U3.48 (VCAP1)
unnamed: C23.1, U3.73 (VCAP2)
RX: J1.2, U3.87 (PD6)
SCK: R27.2, U1.31 (VDS), U3.52 (PB13)
SDI: U1.30 (IDRIVE), U3.53 (PB14)
SDO: R4.2, U1.29 (MODE), U3.54 (PB15)
SHA: NT8.1, R15.2, U1.9 (SHA)
SHB: NT9.1, R22.2, U1.16 (SHB)
SHC: NT10.1, R26.2, U1.19 (SHC)
SNA: NT4.2, NT13.1, NT14.1, R1.1_1, R1.1_2, U1.12 (SNA)
SNB: NT5.2, NT11.1, NT12.1, R7.1_1, R7.1_2, U1.13 (SNB)
SNC: NT6.2, NT15.1, NT16.1, R8.1_1, R8.1_2, U1.22 (SNC)
SOA: U1.25 (SOA), U3.17 (PC2_C)
SOB: U1.24 (SOB), U3.16 (PC1)
SOC: U1.23 (SOC), U3.15 (PC0)
SPA: Q2.3 (S), R1.2_1, R1.2_2, U1.11 (SPA)
SPB: Q4.3 (S), R7.2_1, R7.2_2, U1.14 (SPB)
SPC: Q6.3 (S), R8.2_1, R8.2_2, U1.21 (SPC)
SWCLK: TP2.1, U3.76 (PA14)
SWDIO: TP1.1, U3.72 (PA13)
TX: J1.1, U3.86 (PD5)
VDRAIN: NT7.2, U1.7 (VDRAIN)
VM: C4.1, C5.1, C6.2, C7.2, C10.2, C11.2, C12.2, NT7.1, P4.1, Q1.2 (D), Q3.2 (D), Q5.2 (D), R2.1, R13.1, U1.6 (VM), U1.47 (VIN)
VOA: R18.1, U3.30 (PA6)
VOB: R19.1, U3.35 (PB1)
VOC: R23.1, U3.31 (PA7)
nFAult: R3.2, U1.28 (NFAULT), U3.58 (PD11)

Notes on the sheet:
POWER SENSING
Rezistenete alese ca sa fie pt 75v aprox 5v la divizor de tensiune(3mA)
DRV8323RSRGZT NU E COMPONENTA ORIGINALA. COMPONENTA ORGINALA ERA DRV8323RH CARE ARE GAIN HARD

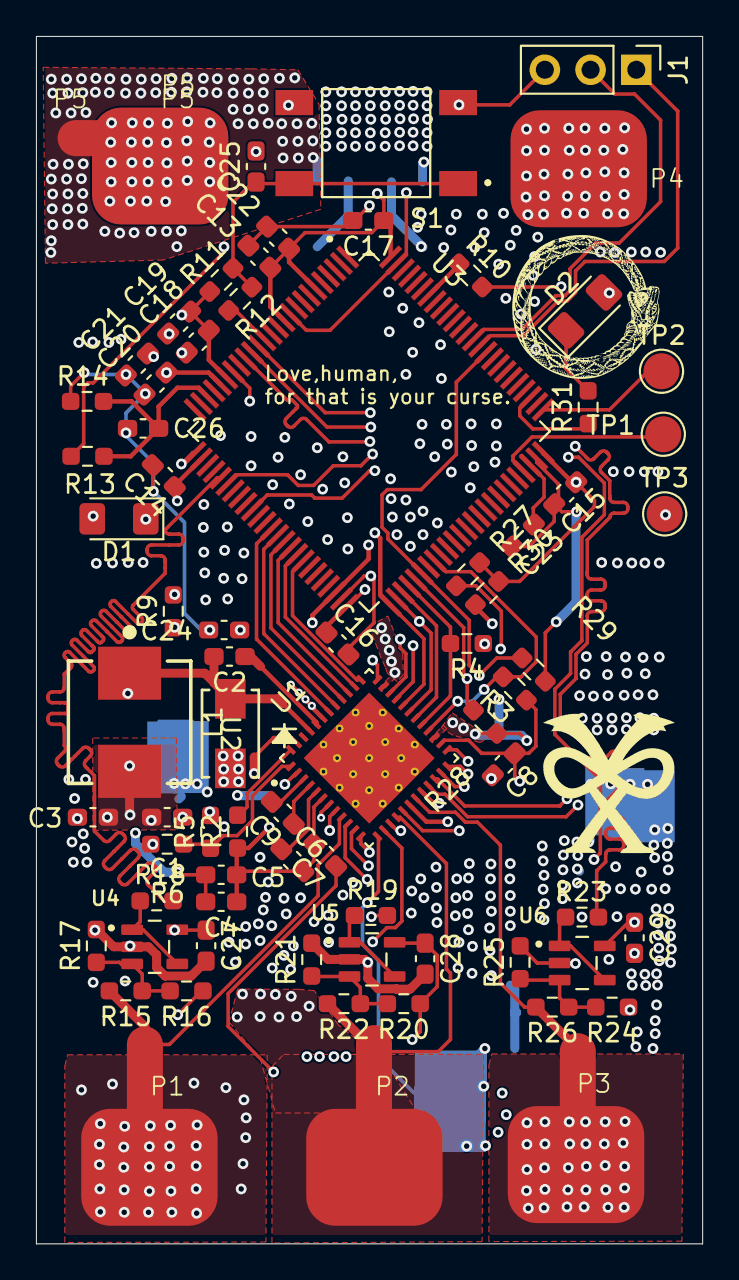
[picture p21: board ESC_HF.kicad_pcb from above]

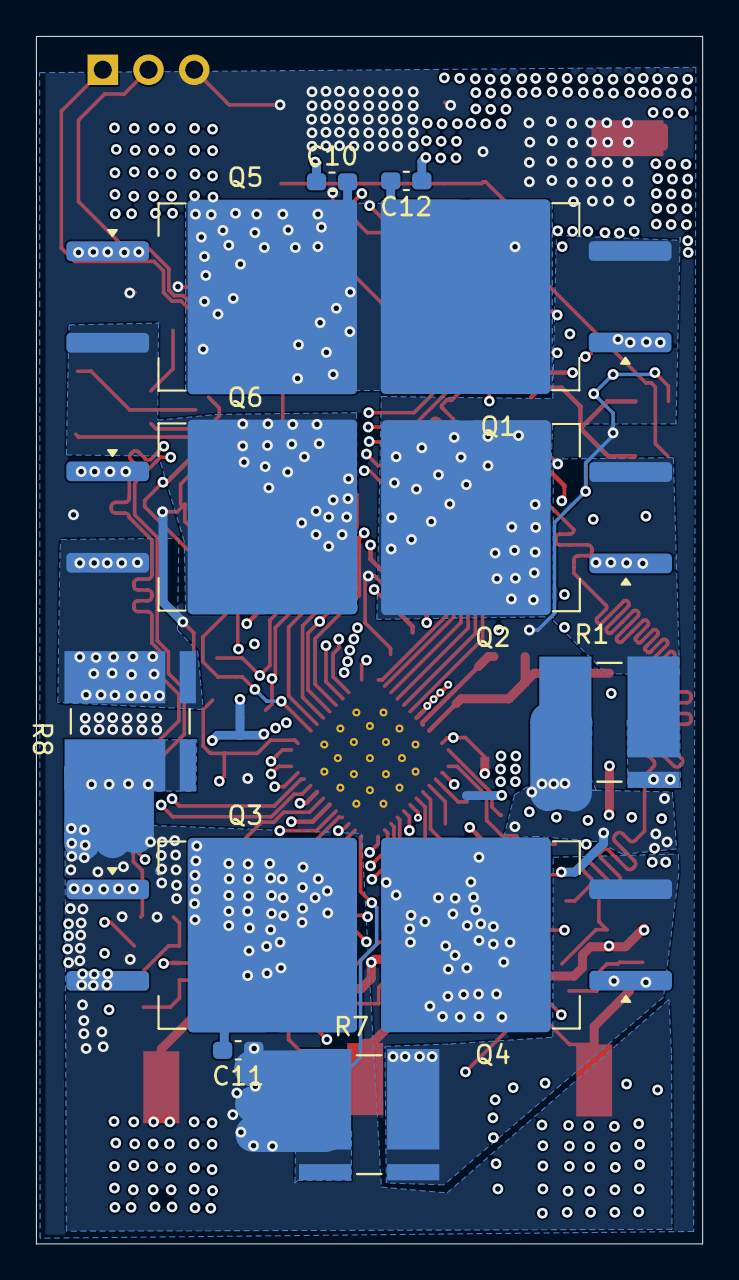
[picture p22: board ESC_HF.kicad_pcb from below]

Board: 6 copper layers, 37.0 x 67.1 mm, 101 parts (23 on the bottom side), 72 nets.
