LuCy4n3/ESCboard/(commit log)

2026-11-10 Initial ESC_HS firmware, documentation and hardware checklist
    [BOM.csv, BOM.xlsx, BOM_components.csv, Curr_sens.kicad_sch, MCU.kicad_sch, Temp_meas.kicad_sch, conn.kicad_sch, demux.kicad_sch]
2026-11-10 Organize ESC v1 and v2 with hardware designs and BOM
    [BOM.csv, BOM.xlsx, BOM_components.csv, CST272FK-13-R001AA.step, Curr_sens.kicad_sch, DRV8323RHRGZR.step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]
