LuCy4n3/ESCboard/(notices)

Notices in the files:
v1/ESC_HS/Core/Src/main.c:
Copyright (c) 2026 STMicroelectronics.
All rights reserved.
This software is licensed under terms that can be found in the LICENSE file
